arekosinski/samd21_minimal_board/(commit log)

2021-01-01 minimal board for SAM D21
    [samd21g_minimal_board.sch]
2021-01-09 board image
